ForrestErickson/OctoUNO/OctoUNO.ino

/*OctoUNO
   A program for an Arduino Uno
   Makes UNO into an elementary curve tracer like an Ocotpus
   DISPLAY IV plot on PC with Processing.
   Useful for checking in circuit semiconductors and more.

   Author: Forrest L Erickson
   Date: 20210720  Happy Moon Landing Anniversary
   License: Dedicated to the public domain.
   Free to use. This program is designed to kill you but not guaranteed to do so.
   Date: 20210721 Rework circuits per note book Start 2013 Page 79 and then page 81.
   Date: 20210722 Got working with Proccessing DISPLAY program
   Date: 20210723 Added SCPI like command processor for start, stop, reset and IDN.
   Add version number.
   Date: 20210924 Broke out Wink into module. Broke out Commands into module.
   Date: 20210924 Debounce the start and stop button with DailyStruggleButton library. NICE!.
   Date: 20210311 Change button capture from D2 to D3 to match the KiCAD SMD PCB Version 0.0.1.
   Date: 20211101 Add delay at bottom of ramp so the falling edge at output of the filter gets low.
   Date: 20211101 Impliment minimal CLS command.
   Date: 20211101 Change version to 4.
   Date: 20211103 Change version to 5.  Add offset to zero current measurement.
   Date: 20211103 Change version to 6.  Fixed call to wink in loop.
   Date: 20211105 Change version to 7.  Send Idut as uA on serial port. Remove dead button code.
   Date: 20211106 Auto format.
*/

/*  Details: An Ocotpus curve tracers sources and sinks current into a two pin single port and plots the IV curve.
    If the DUT is and IC we are typicaly typicaly interested in probing the ESD input protection diodes.
    We typically test the device unpowered with VCC shorted to VSS (GND) and we probed with a positive and negative current limited voltage ramps.

    For the OcotUNO This will be done with done using one PWM output filtered and double buffered to make Vtest.
    The DUT will be tested by connecting from the Vtest into a Theven source at Vcc/2 with RThev = Req =10K/2

   Pinout
   Vtest from WPM on Pin 5.
   A0 to ICPin under test at Vtest
   A1 to ICPin under test at Vthev

   The current in the DUT is about 1uA per setup size from 1023/2

   RESULTS: The ramp voltage is from 1 to about 4.6 Volts. Ramp time is about 210mS when delay is 300uS.
*/

// Import required libraries
//--------------- Includes ---------------------------
#include <DailyStruggleButton.h> //Loaded from Arduino libray manager. See also: https://github.com/cygig/DailyStruggleButton
//#include "Arduino.h"
#include "wink.h"
#include "commands.h"
#include "buttons.h"

//Some program constants
extern const String COMPANY = "Amused Scientist";
extern const String MODEL_NAME = "OctoUNO";
extern const String VERSION = "0.0.7";    //Scale Idut for uA.

//Hardware setup
#define VccTest  5    //Use PWM output 5, 980Hz.
//extern const int BUTTON_CAPTURE = 2;   // Prototype, ExpressPCB Button to GND.
extern const int BUTTON_CAPTURE = 3;   // KiCAD board Button to GND.
extern const int RESET_PIN = 12;   // To Drive HW Reset.

const int VCC = 5;  //Volts
const int VMID = 512; //Ideal midpoint as read by ADC.
int VOFFSET = 1; //Ofsset to midpoint as read by ADC.  For PCB #1.
//int VOFFSET = 7; //Ofsset to midpoint as read by ADC.  For PCB #2.

const int REQ = 5000;   //REQ is the Rthevenin of 10K // 10K
const int MAXPWM = 255;
const int STEPSIZE = 1;
const long SAMPLEDELAYTIMEuS = 300;  //Gives fast curver trace.

//const long BAUD =  115200;  // Slower but compatible with other deveopment.
const long BAUD =  1000000;  // For fast curve tracing.

//Variables for measurements
int ii = MAXPWM / 2; // Mid point
int Vdut = 0;
int Idut = 0;

// Create an instance of DailyStruggleButton
DailyStruggleButton myButton;

extern unsigned int longPressTime;
extern unsigned int multiHitTime;
extern byte multiHitTarget;

//State of Octopus curve tracing set at start.
extern boolean isCaptureOcotopus = false;

//String variable global
String inputString = "";         // a String to hold incoming data

void captureOctopus() {
  //Curve Trace. Measure A0, A1
  //Calculate Vdut and Idut
  int VdutPlus = analogRead(A0);
  int VdutMinus = analogRead(A1);
  Vdut = VdutPlus - VdutMinus;
  //  Idut = (VdutMinus - (VMID+VOFFSET)); //uAmps
  Idut = int(((VdutMinus - (VMID + VOFFSET)) * ((5 * 1000000) / 1024) / REQ)); //I=V/Req *1000000 = ADC * (5/1024)/5000 *1000000 / REQ for uA

  //The Processing display program expects two comma seperated integers
  Serial.print(Vdut);
  Serial.print(", ");
  Serial.println(Idut);

  //Ramp VccTest
  analogWrite(VccTest, ii);
  ii = ii + STEPSIZE;
  if (ii > MAXPWM) {
    ii = 1;
    analogWrite(VccTest, ii);
    delay(50); //Delay to let saw tooth go low.
  }
  delayMicroseconds(SAMPLEDELAYTIMEuS);     // This makes a display good for oscilliscope.
}//captureOcotpus


void setup() {
  // put your setup code here, to run once:
  Serial.begin(BAUD);
  // reserve 200 bytes for the inputString:
  inputString.reserve(200);

  //Button
  pinMode(BUTTON_CAPTURE, INPUT_PULLUP);      // set

  // Use set(digital pin connected to button, a callback function, type of pull-up/down) to initialise the button
  // Choose between INT_PULL_UP, EXT_PULL_UP and EXT_PULL_DOWN
  //myButton.set(4, buttonEvent, INT_PULL_UP);
  myButton.set(BUTTON_CAPTURE, buttonEvent, INT_PULL_UP);

  // You can enable long press to use this feature
  myButton.enableLongPress(longPressTime);

  // You can enable multi-hit to use this feature
  myButton.enableMultiHit(multiHitTime, multiHitTarget);

  pinMode(LED_BUILTIN, OUTPUT);      // set the LED pin mode
  digitalWrite(LED_BUILTIN, HIGH);   // turn the LED on (HIGH is the voltage level) Start of setup()

  //Set PWM drive pins to octopus output.
  pinMode(VccTest, OUTPUT);
  analogWrite(VccTest, 127);  //Set to mid point
  //  Serial.println("Starting OcotUNO now.");      //For troubleshooting.
  digitalWrite(LED_BUILTIN, LOW);   // end of setup()
}// end setup

void loop() {
  // put your main code here, to run repeatedly:
  winkLED_BUILTIN(); //the built in LED.

  if (isCaptureOcotopus) {
    captureOctopus();
  }

  // This is needed to poll the button constantly
  myButton.poll();

  //Proccess serial commands
  checkCommands();

}//end loop
