ForrestErickson/OctoUNO/(commit log)

2021-07-21 Experiments with PWM but the hardware became complex and not working well. See notebook Start 2013 pages 76-78.
    [OctoUNO.ino]
2021-07-21 Rework circuits per note book Start 2013 Page 79.
    [OctoUNO.ino]
2021-07-21 Sweeping voltage and measureing current. Report out serial port.
2021-07-22 Add photograph of schematic.
2021-07-22 Create README.md
    Project description with screen shot and schematic photographs.
2021-07-23 Add a switch. Capture only when switch pressed.
2021-09-24 Broke out Wink into module. Broke out Commands into module.
    [OctoUNO.ino, commands.cpp, wink.cpp]
2021-09-24 Add the DailyStruggleButton library for button debounce and use it. This works.
2021-09-28 Add DailyStruggleButton library and modules for button management.
2021-11-02 Update for button on KiCAD PCB D3, Impliment minimal CLS command, add delay to PWM falling edge. Updtate UNO code to V 0.0.4. Update Display to send "q" to reset instrument, "c" for *CLS command. Upd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
    [Display.pde, OctoUNO.ino, UserInterface.pde, commands.cpp]
2021-11-03 Change version to 5. Add offset to zero current measurement.
2021-11-03 Change version to version 6, Fixed call to wink in loop.
    [OctoUNO.ino]
2021-11-06 Change version to 7. Send Idut as uA on serial port. Remove dead button code.
2021-11-06 Rev 0.0.5. Calibrate current scale. Add mouse cursor report for V and I. Move program name ect. to window.
2021-11-06 Update README.md
    Updated with change history. New screen shot of Processing Display with calibrated scales and cursor cross and readout added today.
